kishannareshpal/mareografo/docs/images/ultrasonic-module.jpg

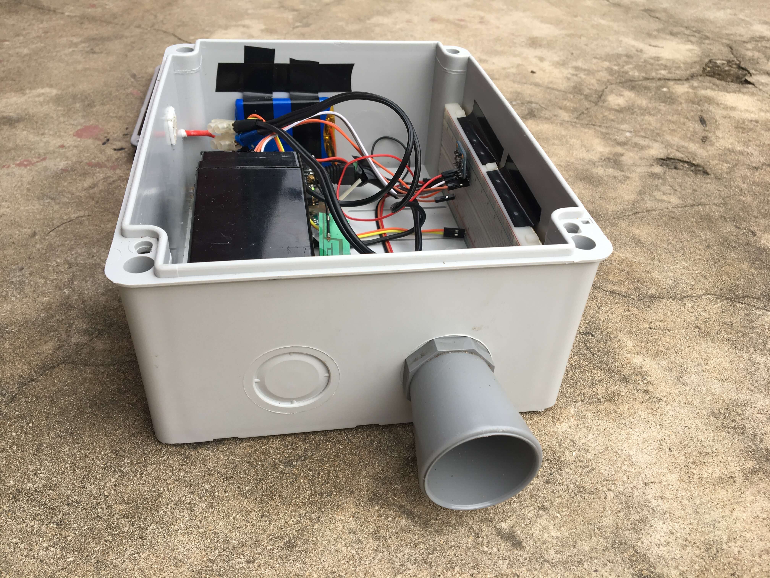
docs/images/ultrasonic-module.jpg
